ivveshermosilla/Holmes-HWF0910AT-Window-Fan-Smart-Mod/docs/architecture.md

# Architecture

The design separates low-voltage control from the fan's mains power path. An
isolated HLK-10M05 supplies the ESP32-S3 domain. H11AA1 optocouplers report the
AC zero crossing and four original slider contacts. A MOC3023 transfers the
controller's firing command back across the isolation boundary to a BTA08 TRIAC.

```mermaid
flowchart LR
  AC[120 VAC input] --> F[Fuse and protection]
  F --> HLK[HLK-10M05 isolated 5 V]
  HLK --> ESP[ESP32-S3]
  F --> ZC[H11AA1 zero-cross]
  ZC --> ESP
  F --> S[Original sliders]
  S --> H[4 x H11AA1 sensing]
  H --> ESP
  ESP --> MOC[MOC3023 optotriac]
  MOC --> TRIAC[BTA08-600C TRIAC]
  TRIAC --> MOTORS[Twin AC motors]
  ESP --> BUF[SN74AHCT125 level shifter]
  BUF --> LEDS[7 x addressable LEDs]
  ESP --> TEMP[DS18B20]
  ESP --> BTN[New push button on perfboard]
  ESP <--> PWA[Local PWA / OTA]
```

## Control Layers

1. Interrupt handlers timestamp H11 edges and wake a dedicated TRIAC-fire task
   at each zero crossing.
2. The main loop derives mains presence, slider position, temperature, and time.
3. A state machine resolves button, web, thermostat, timer, and schedule requests.
4. The high-priority fire task runs on the other ESP32-S3 core and issues the
   calibrated MOC pulse independently of HTTP/PWA and OneWire processing, so
   loading or logging into the app cannot pause motor firing.
5. LED rendering derives its normal state from the resolved fan mode.
6. HTTP APIs expose state and accept explicit commands; page load is read-only.

The MOC pulse counter is command telemetry. It proves that firmware requested a
gate pulse while the safety conditions were satisfied; it cannot prove current
through the TRIAC or motor. That distinction is important in diagnostics.
