ivveshermosilla/Holmes-HWF0910AT-Window-Fan-Smart-Mod/docs/firmware.md

# Firmware

The Arduino sketch is in
[`firmware/Holmes_HWF0910AT_Smart_Mod/`](../firmware/Holmes_HWF0910AT_Smart_Mod/).
The `data/` directory is the LittleFS image served by the ESP32-S3.

## Safety State Machine

At boot the MOC output is forced low and the mode is `OFF_LOOP`. When zero-cross
activity first establishes that VAC is present, the controller again forces OFF;
the schedule may resume only after VAC is confirmed, the two-second safety
interval has elapsed, and the clock is synchronized.

Short button presses follow:

```text
OFF -> HIGH -> LOW -> HIGH 60 -> HIGH 65 -> HIGH 70 -> HIGH 75 -> HIGH 80
    -> LOW 60 -> LOW 65 -> LOW 70 -> LOW 75 -> LOW 80 -> OFF -> ...
```

A long press of approximately 2.5 seconds from an active original mode enters a
volatile `OFF_MEMORY`; the next short press restores that mode. Removing power
clears the memory. A short press from a custom web speed first returns to OFF.

Every stopped-to-running transition applies 100% for two seconds, then moves to
the requested phase delay. Adjusting an already-running fan does not repeat the
boost.

Zero-cross events wake a dedicated high-priority FreeRTOS task that owns the
short GPIO47/MOC pulse. HTTP serving remains in the application loop, but cannot
delay the phase-fire task. Status telemetry exposes `fireTaskReady`, pulse count,
last pulse gap, and maximum pulse gap so this separation can be regression-tested
while another device loads or logs into the PWA.

## Thermostat And Schedule

Thermostat modes stop at or below the target and resume above it with configured
hysteresis. Weekly entries share one interval among selected start days. Daily
entries retain a separate interval per selected day. An end earlier than start
belongs to the following day; equal times disable that interval.

Schedules and their speed/dimmer values persist in ESP32 Preferences NVM.
The clock is obtained independently from SNTP after Wi-Fi joins the LAN. The
firmware uses the `America/Denver` daylight-saving rule for weekday and minute
boundaries. A browser can also provide the time when SNTP is unavailable;
opening the app never sends a motor command. With no RTC battery, a total power
loss followed by no LAN/Internet and no browser leaves the clock unknown, so the
schedule waits for valid time while manual control remains available.

Clock synchronization is explicitly requested at boot, on each LAN IP recovery,
on VAC recovery, when a client joins the recovery AP, and when the PWA opens or
recovers access. A separate request is made when the Denver local clock crosses
12:00 AM each day, including daylight-saving days. Manual synchronization does
not reset that daily boundary or clear pending automatic requests. Requests are
coalesced and retried at a minimum 15-second interval while the LAN is connected;
without Internet they remain pending while an already valid clock keeps running.
The PWA requests NTP on reconnection and supplies browser time only if the clock
is unknown or the LAN is unavailable. Automatic reconnection does not replace a
valid online clock with the connecting phone's time. Manual Sync still applies
browser time directly. None of these handlers sends a motor command.

`/api/status.time` exposes `lastNtpEpoch`, `lastManualEpoch`, `syncRequests`,
`syncAttempts`, `syncCompletions`, `midnightSyncRequests`, and the reason bitmasks
`syncPending`/`syncLastReasons`: boot=1, LAN=2, AC=4, AP client=8, PWA=16,
midnight=32. A pending request is cleared only by a received NTP response.

An active schedule window owns its end boundary, even when a web command or
button press changes the running mode. If manual control has already started
the motor before a window begins, the window does not restart it or change its
speed; it still turns it off at the scheduled end. Outside the selected window,
manual controls work normally. A manual OFF during a window remains OFF until
the next selected window. After a boot or VAC reconnection inside a window, the
motor resumes only after the AC safety interval.

Temperature history stores one hourly sample for seven days in NVM.
Hourly samples are captured in RAM while motor output is active and committed
after output stops, avoiding flash-backed NVM stalls during TRIAC firing.

Scheduled intermediate speeds use `SPEED_CUSTOM` under schedule ownership. This
authority is independent of the manual custom-slider checkbox: the checkbox
continues to govern direct web control, while an active schedule can apply its
own saved 85-100% value without changing that preference.

## Persistent Power Tracking

Firmware keeps a bounded ring of up to 64 events and exposes it on demand at
`/api/power-log`. Once local time is synchronized, entries older than 24 hours
are removed. Events include ESP reset reason, AC detection/loss,
motor ON/OFF and its requesting subsystem, app session checks, MOC output
blocking/restoration, and TRIAC firing gaps above 12,500 microseconds.

Event capture is immediate in RAM. NVM persistence is deferred whenever the
motor request or TRIAC fire task is active, preventing a diagnostic write from
adding flash latency to phase firing. The next OFF transition commits the full
pending log. This records software decisions and pulse timing; without a
tachometer or isolated current sensor it cannot prove physical blade rotation.

## Zero-Cross And AC Sessions

The zero-cross ISR records each rising-edge interval. Pulse age is calculated
from a timestamp taken after the ISR snapshot, preventing an interrupt between
the two reads from producing an unsigned underflow and a false stale signal.

A gap shorter than 250 ms can temporarily inhibit firing through the normal
freshness gate without changing fan mode or schedule ownership. A gap of at
least 250 ms is treated as an actual AC interruption; the following stable
return executes the required AC-connected safety OFF. This decision is based on
the measured pulse interval, not on how long HTTP work delayed the main loop.
Status exposes both `ageUs` and `sampleElapsedMs` for diagnosis.

## Build

Reference Arduino-ESP32 target options:

```text
esp32:esp32:esp32s3
FlashSize=4M, PartitionScheme=default, FlashMode=dio, CPUFreq=240
PSRAM=disabled
```

Compile with Arduino IDE/CLI using the ESP32 core and the Adafruit NeoPixel
library. Build LittleFS separately from `data/`; for the current 4 MB default
partition layout its image size is `0x160000`. Confirm the partition table from
the compiled build rather than assuming an offset on different boards.

## OTA

System settings accept two distinct Arduino binary artifacts:

- Firmware: the compiled sketch `.bin` sent to the firmware endpoint.
- UI: the generated LittleFS `.bin` sent to the LittleFS endpoint.

The browser displays upload progress; the ESP validates the write and reboots
automatically after success. Keep power stable. Never upload a filesystem image
whose size or partition scheme differs from the installed firmware.

## Wi-Fi Recovery

The ESP runs in AP+STA mode. Its recovery AP remains available while STA joins
the configured 2.4 GHz LAN. STA association uses the ESP auto-reconnect facility
and an independent non-blocking retry loop. Failed joins retry indefinitely with
5, 10, 20, and then 30-second intervals, covering the common case where the ESP
boots faster than the household router after a power outage.

`/api/status` reports the STA status code, recovery state, attempt count,
consecutive failures, next retry delay, and connection age. The authenticated
`POST /api/wifi/reconnect` endpoint restarts only STA; it does not change the
saved schedule or motor command and does not stop the recovery AP.

## First Commissioning

The public source defaults to AP `IvvesFan-Config` and example subnet
`192.168.1.x`; no household SSID or password is embedded. Generic app and OTA
credentials are intentionally visible in source for first commissioning. Change
all credentials from a trusted connection before permanent installation.
