ivveshermosilla/Holmes-HWF0910AT-Window-Fan-Smart-Mod/docs/webapp.md

# Web Application

The ESP32-S3 serves a framework-free, bilingual PWA from LittleFS. It works as a
single-page application with Home/System views and glass-styled detail overlays.

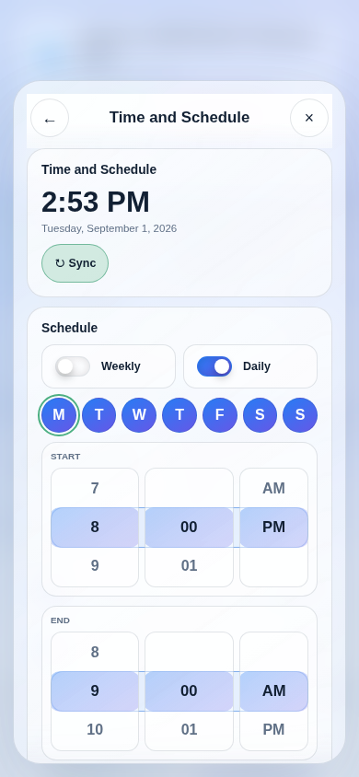
[picture p4: assets/screenshots/mobile-schedule.png]
Mobile schedule


## Home

- Live LAN/AP-recovery, clock sync, zero-cross, and firmware indicators.
- Temperature summary and seven-day hourly detail history.
- Explicit POWER ON (HI) and Power off commands.
- Fan state, shared 85-100% control, HIGH/LOW/temperature presets, and sliders.
- Global LED color/dimmer plus seven physical-function indicators.
- Timer and mutually exclusive Weekly/Daily scheduling with 12-hour time wheels.

## System

- Physical-button enable switch.
- Device-health command telemetry and zero-cross/H11 module activity.
- Persistent Power tracking for the last 24 hours, including reset, AC,
  motor-command, schedule, timer, web, and TRIAC timing causes.
- Wi-Fi scanning, password entry, DHCP connection, last-octet static-IP setup,
  recovery telemetry, and a manual STA-only reconnect command.
- Separate OTA upload controls for firmware and LittleFS with progress/reboot.

## Session Behavior

Unknown devices see an empty login form. A successful login can be remembered in
that browser. Initial page synchronization reads the current state and requests
clock synchronization; opening a second phone does not replay stale controls.
Motor gate timing runs in a separate
real-time task, so serving the login or application assets cannot interrupt an
already active fan mode.

Each app connection or recovery requests NTP through `/api/time` with reason
`app-reconnect`. When the clock is unknown or the LAN is unavailable, the phone
also supplies its current time, even if the fan is already running. A valid
online clock is preserved until NTP responds. Manual Sync directly applies the
browser time. Automatic midnight and reconnection requests remain independent
of manual Sync. Clock corrections allow the saved schedule to evaluate its
actual current start/end boundaries.

Power tracking comes from the ESP32 rather than browser-local activity. Its
  summary and detail overlay show newest events first. A PWA session check is
recorded for correlation, but log writes are deferred while motor firing is
active and committed when the output is stopped. The controller never treats a
page load or login as a fan command.

Periodic synchronization requests only `/api/status` every three seconds. The
larger power log is loaded from `/api/power-log` when System is opened and then
at 30-second intervals while that view remains visible. Seven-day temperature
history is similarly loaded from `/api/temp-history` only when its detail view
opens. This keeps ordinary control telemetry responsive on a weak local Wi-Fi
link without removing either diagnostic record.

The default generic app login is `thankyou` / `youarewelcome`. It is not a cloud
identity system and should be changed during commissioning.

The detail presentation is technically a **modal overlay** (also called a modal
dialog). Cards kept on Home do not open one unless additional detail is useful.
