ivveshermosilla/Holmes-HWF0910AT-Window-Fan-Smart-Mod/docs/engineering-decisions.md

# Engineering Decisions And Challenges

| Challenge | Evidence | Decision and resolution | Validation |
| --- | --- | --- | --- |
| Original supply was not safely isolated | Board tracing contradicted the early assumption | Replace the control board and power the ESP32 from an HLK-10M05 | Isolated controller domain documented and installed |
| H11 inventory/roles changed during tracing | Five optocoupler functions were found | Assign one ZC plus four explicit slider inputs | Live H11 counters and position labels exposed in System |
| LED wiring produced a short | Physical LED test failed before mains testing | Correct wiring before continuing firmware tests | Seven-pixel color and function tests restored |
| GPIO21 and GPIO47 were reversed in an early build | LED and motor behavior contradicted board wiring | Fix LED DATA=21, MOC=47 and reject stale LED-pin NVS | Correct pin map compiled, flashed, and retained |
| DS18B20 accumulated read errors | Presence/read counters showed repeated failures | Correct one-wire timing and GPIO handling | Stable live readings with zero accumulating errors |
| Low speed needs reliable startup torque | Direct low-power starts were mechanically weak | Apply two seconds at full power only from stopped state | HIGH-to-lower transition observed without app-visible bounce |
| Mobile individual color picker closed early | Re-render replaced the active input | Separate immediate preview from state refresh | Picker remains usable and changes render immediately |
| A second browser caused a brief motor interruption | Login sent no motor command, but synchronous HTTP file serving delayed loop-driven MOC pulses | Keep startup read-only and move MOC timing to a dedicated high-priority task | Pulse-gap telemetry verifies continuity while another client loads the PWA |
| Overnight schedules cross weekday boundaries | End time can be numerically earlier than start | Bind weekday to start; carry end into next day | Monday 10 PM to Tuesday 7 AM resolves as one interval |
| Scheduled intermediate speed did not run when the manual slider checkbox was off | Schedule mode selected `CUSTOM`, but motor logic still required the unrelated manual enable flag | Give active schedule control independent authority over its persisted 85-100% value | Live 93% schedule reported motor requested, fire allowed and stable firing |
| Intermittent stops needed evidence without creating new timing stalls | Browser activity was volatile and immediate NVM writes can stall flash-backed execution | Keep a 24-hour bounded controller log in RAM while firing and flush it after output stops | Reset, command and pulse events survive reboot; 12-session load produced no new gap event |
| Live 120 Hz ZC was intermittently classified stale | `micros()` was captured before the ISR snapshot, allowing an intervening edge to underflow unsigned pulse age; slow status responses could then exceed the 1.5 s AC threshold | Timestamp after snapshot, detect real AC sessions from ISR-measured gaps >=250 ms, preserve mode through shorter gaps, and split large histories from periodic status | Installed schedule remained driving under concurrent client load with stable ZC and no additional AC transition |
| 5 GHz network could not be joined | ESP32-S3 scan/join behavior | Provision a 2.4 GHz SSID through AP mode | LAN operation and OTA established |
| OTA must update code and UI independently | App and LittleFS use separate partitions | Provide two upload endpoints and progress/reboot flow | Both image types accepted and served after reboot |

The record deliberately includes failures because the corrective loop is part of
the engineering outcome: observe, isolate the cause, reduce risk, change one
thing, and verify the real device.
