ivveshermosilla/Holmes-HWF0910AT-Window-Fan-Smart-Mod/docs/gallery.md

# Project Gallery

Only representative images are included. The source set remains private because
raw phone images contained location metadata and Live Photo companions. Public
derivatives were auto-oriented, resized, and stripped of metadata.

## Condition And Investigation

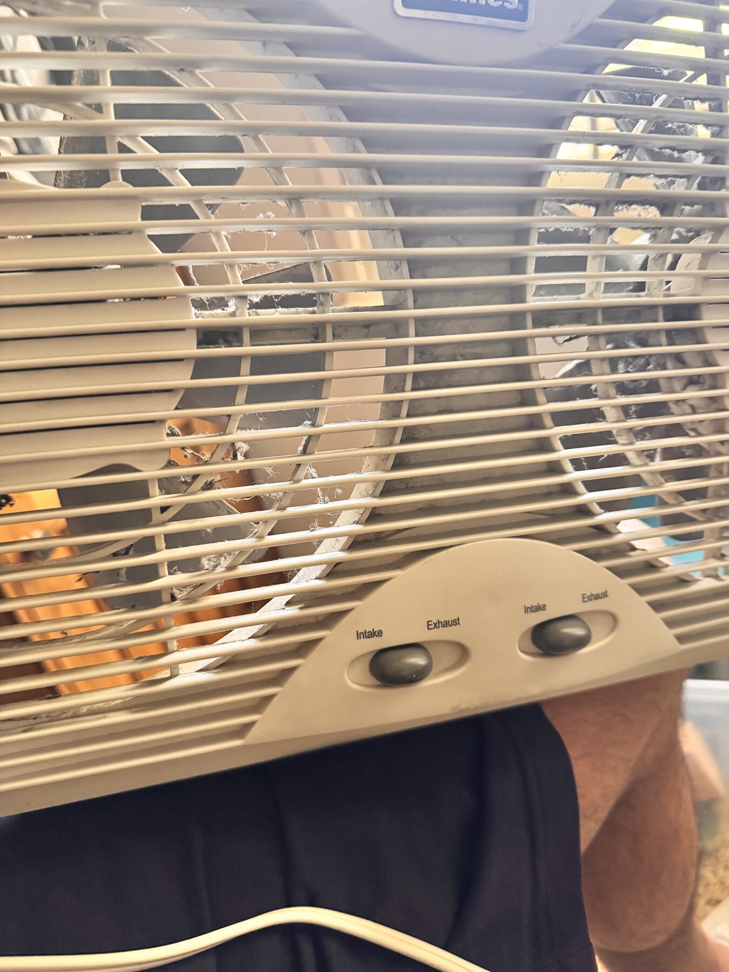
[picture p5: assets/photos/01-condition-as-received.jpg]
Condition as received


**Condition as received, before service.** The fan was operational but had
accumulated dust and lint during extended airflow duty, as window fans normally
do. The condition was documented before disassembly rather than concealed.

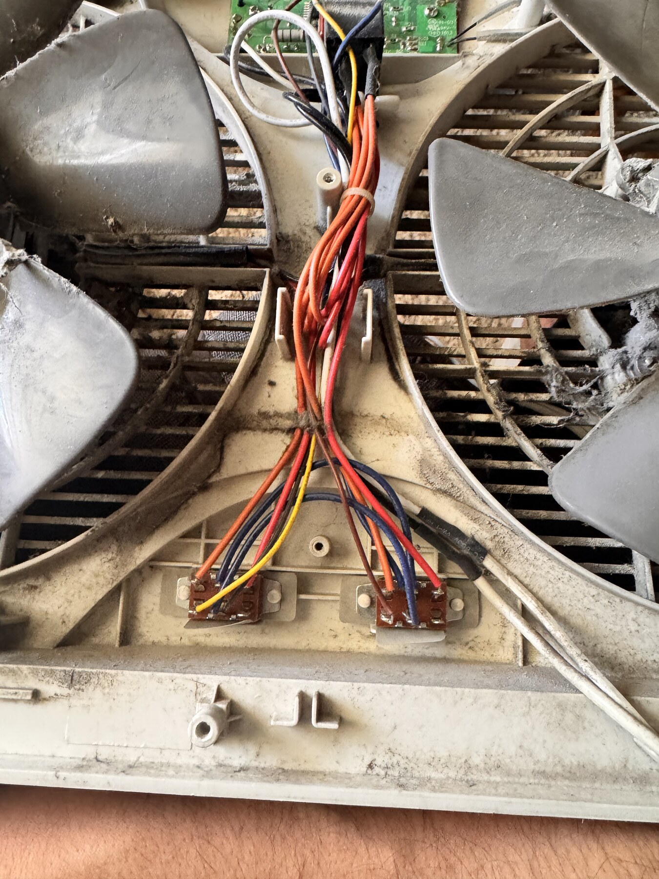
[picture p6: assets/photos/02-original-internals.jpg]
Original internals


Original internal layout before replacement of the non-isolated controller.

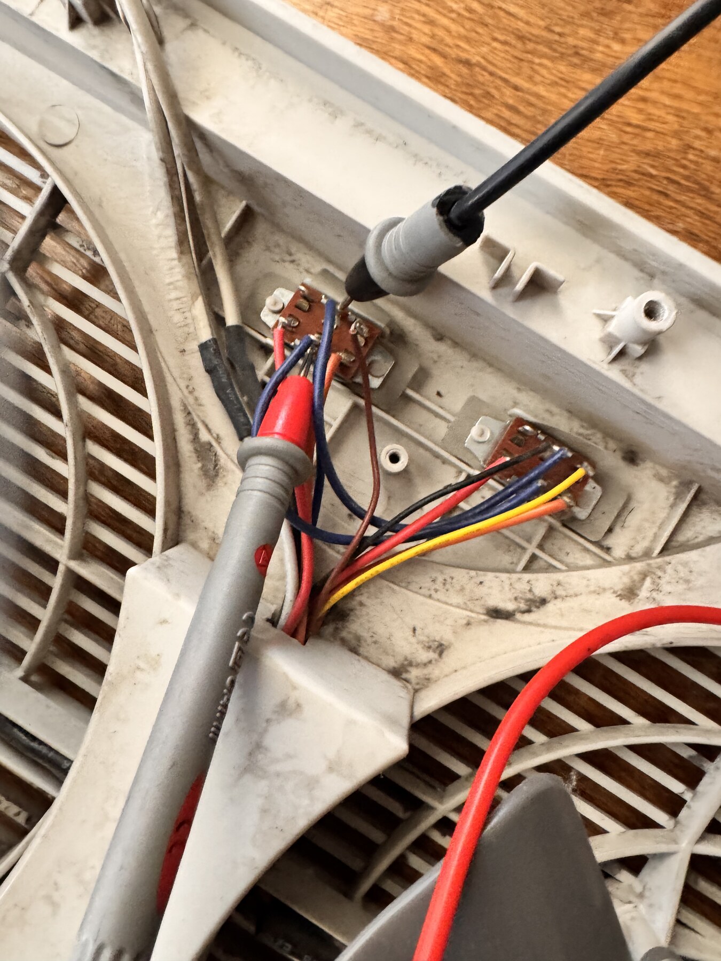
[picture p7: assets/photos/04-reverse-engineering-measurement.jpg]
Reverse-engineering measurement


Tracing and measuring the existing control paths before assigning GPIO roles.

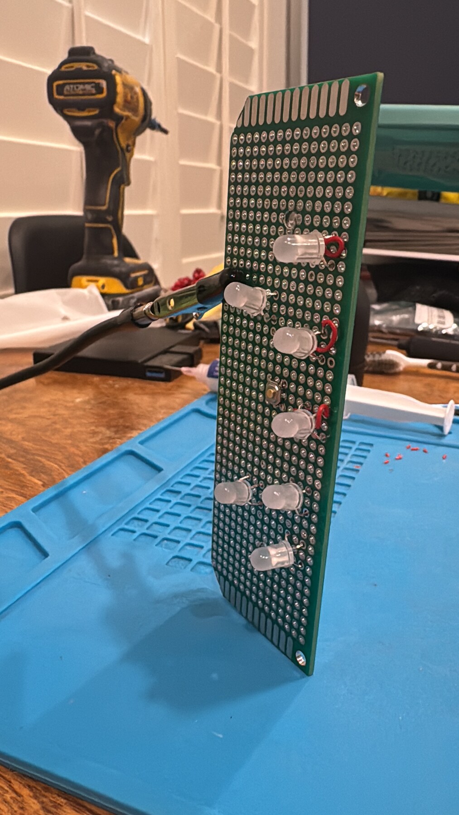
[picture p8: assets/photos/05-indicator-board-layout.jpg]
Indicator board


The original seven-position indicator layout informed the final LOW/temperature/
HIGH order and the digital representation in the PWA.

## Smart Mod Integration

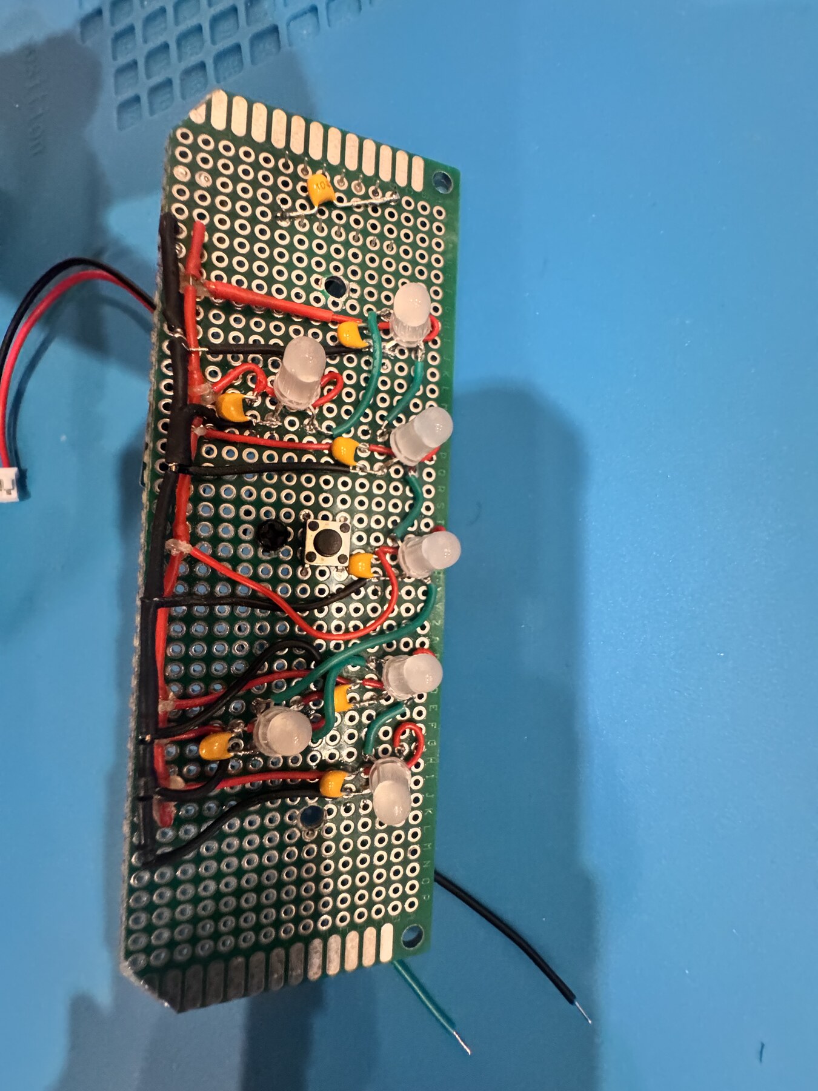
[picture p9: assets/photos/06-controller-board-assembly.jpg]
Controller assembly


Low-voltage controller assembly during integration.

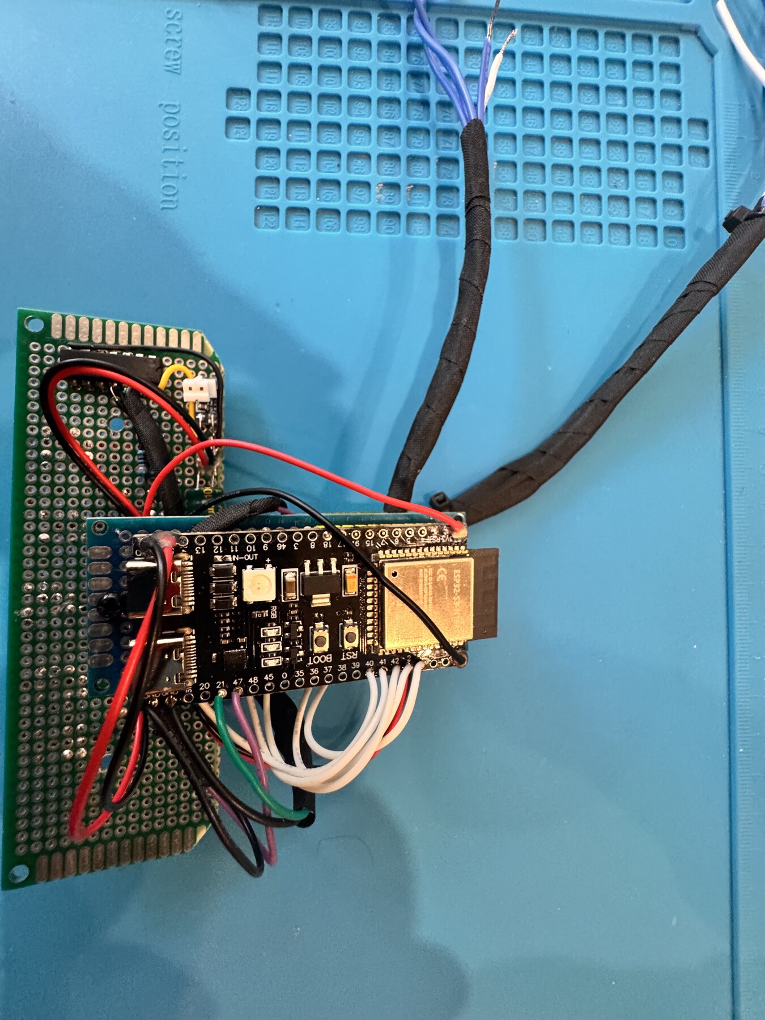
[picture p10: assets/photos/07-esp32s3-controller-complete.jpg]
Completed ESP32-S3 controller


Completed ESP32-S3 controller before final installation.

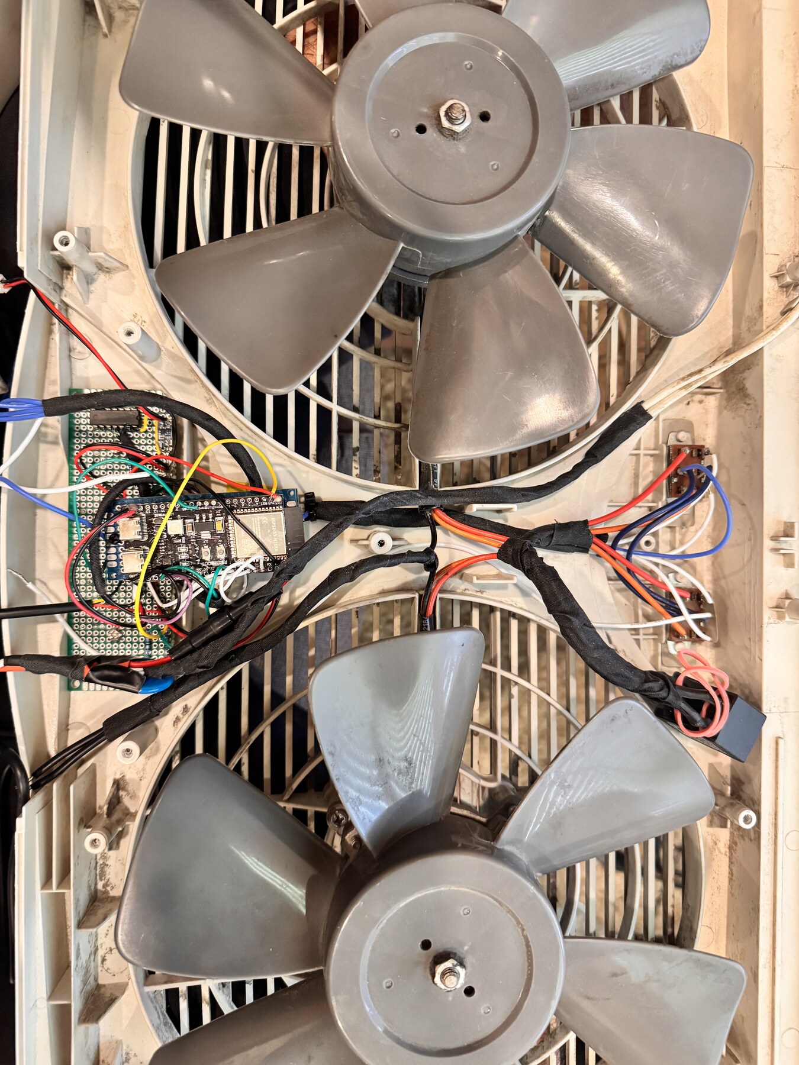
[picture p11: assets/photos/08-controller-installed.jpg]
Controller installed


Controller installed in the fan enclosure.

## Final Condition After Service

Front after service

Front view after service and integration.

Rear after service

Rear view after service. The before/after comparison records the improvement
without presenting normal accumulated dust as the owner's living conditions.

## Application

Desktop Home

Desktop Home view served by the installed firmware.

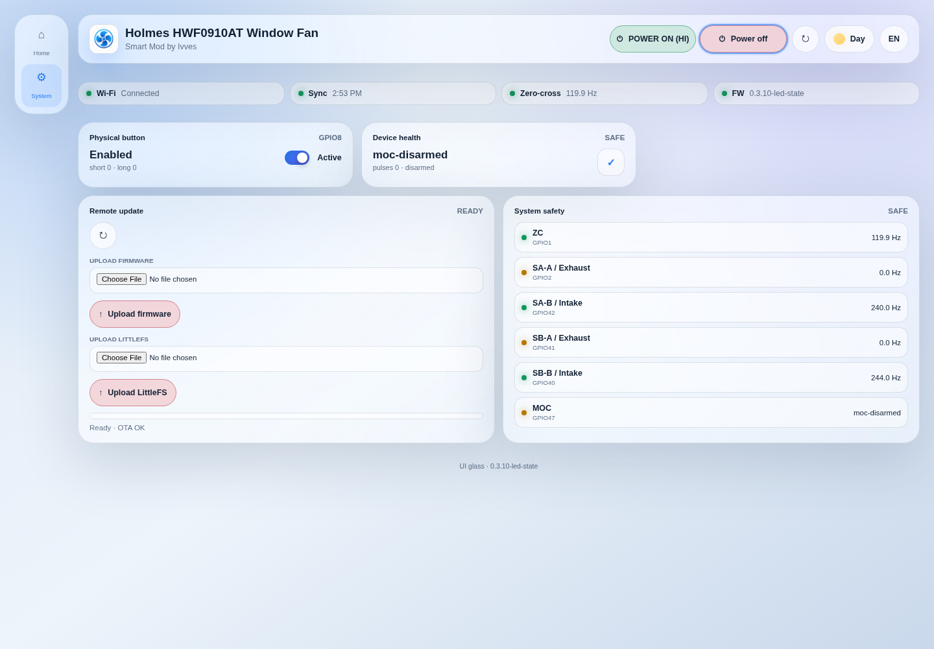
[picture p12: assets/screenshots/desktop-system.png]
Desktop System


System diagnostics and separate firmware/LittleFS OTA controls. Household Wi-Fi
and activity details were intentionally excluded from the portfolio capture.

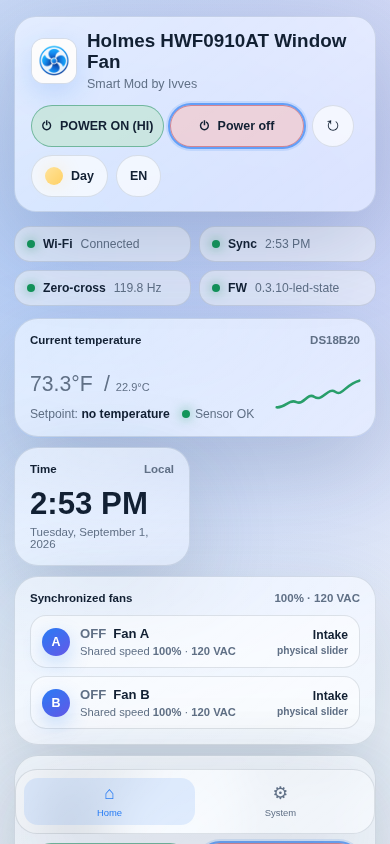
[picture p13: assets/screenshots/mobile-home.png]
Mobile Home


Installable mobile PWA layout.

Mobile schedule

Daily schedule and native-style 12-hour time wheels.
