ivveshermosilla/Holmes-HWF0910AT-Window-Fan-Smart-Mod/assets/diagrams/README.md

# Diagrams

Architecture and connection diagrams are maintained as Mermaid source inside the
Markdown documentation so GitHub can render them and future electrical changes
remain reviewable as text.

- [`docs/architecture.md`](../../docs/architecture.md): system and isolation blocks
- [`docs/hardware.md`](../../docs/hardware.md): MOC/TRIAC connection network
- [`docs/pinout.md`](../../docs/pinout.md): GPIO and indicator maps
- [`docs/firmware.md`](../../docs/firmware.md): physical-button state sequence
