ivveshermosilla/Holmes-HWF0910AT-Window-Fan-Smart-Mod/docs/testing.md

# Testing And Validation

## Bench Stages

1. Power-off continuity and component identification.
2. Isolated 5 V bring-up with mains motor output disabled.
3. LED and DS18B20 tests after correcting physical wiring.
4. Zero-cross frequency and four H11 activity checks at 120 VAC.
5. MOC/TRIAC firing with both original sliders in known positions.
6. HIGH/LOW/custom speed, two-second boost, OFF, thermostat, and button loop.
7. Timer and weekly/daily same-day and overnight schedule behavior.
8. PWA login, mobile layout, second-device read-only synchronization, and PWA assets.
9. Firmware and LittleFS OTA upload followed by automatic reboot and status check.

## Current Evidence

- Reference version: `0.3.19-clock-reconnect`.
- Zero-cross telemetry near 120 edge events per second on 60 Hz mains.
- DS18B20 live values with no current read-error accumulation.
- MOC remains disarmed while OFF; commanded pulse count increments only when armed.
- Four slider optocoupler channels expose live activity and Intake/Exhaust labels.
- Desktop and mobile screenshots were captured directly from the installed PWA.
- The operating sketch compiled at 1,077,365 bytes (82% of the app partition)
  with 50,380 bytes (15%) of global RAM. The sanitized public sketch compiled at
  1,077,233 bytes with the same global RAM use.
- Twelve complete PWA downloads plus twelve new-device logins completed with no
  HTTP failures while HIGH remained active.
- During that test `firePulseCount` reached 7,714, zero-cross stayed at 120.0 Hz,
  and the maximum fire gap was 8,437 us, below a missed 60 Hz half-cycle.
- DS18B20 recorded zero read, reset, and CRC errors through 67 successful resets
  during the same motor/network load test.
- A live schedule test selected `CUSTOM` at 93% with the manual custom checkbox
  false. Status reported mode 13, `motorRequested=true`, `fireAllowed=true`,
  schedule driving, 93%, and the scheduled 37% LED dimmer after the two-second
  start boost.
- Twelve simulated new-device flows each requested session, login, application,
  config, and status while that 93% schedule was active. TRIAC pulses increased
  from 868 to 2447, the maximum gap remained 9487 us, and no output-gap or
  output-blocked event appeared.
- Restoring the saved Daily schedule produced matching persistent ON/OFF events
  at 93%, returned the controller to OFF, and preserved the original seven-day
  schedule values.
- The 0.3.15 LittleFS image used PWA cache `hwf0910at-pwa-v5`.
- The 0.3.16 operational sketch compiled at 1,081,817 bytes (82%) with
  51,684 bytes of global RAM; the public sketch compiled at 1,081,673 bytes.
- Firmware and LittleFS OTA completed with the saved Daily schedule intact.
  After local-time synchronization it resumed `CUSTOM` 100%, schedule driving,
  motor requested, MOC armed, and firing allowed at approximately 120 Hz.
- Periodic status is 4,568 bytes; the 6,578-byte power log and 1,188-byte
  temperature history are fetched separately. Installed source and served PWA
  hashes matched, and the cache is `hwf0910at-pwa-v6`.
- Twelve complete app-entry flows preserved scheduled output. A subsequent
  ten-minute test used three clients polling status every three seconds plus a
  fourth client loading the power log every 30 seconds: 579 status samples, 20
  log requests, zero HTTP errors, zero invalid fan states, zero unstable ZC
  samples, and 71,982 additional TRIAC pulses. Maximum request latency reached
  3.056 seconds without changing AC state; maximum fire gap remained 8,488 us.
- Final installed state was left running from the saved Daily schedule at
  `CUSTOM` 100%, with schedule active/driving, MOC armed, firing allowed,
  120.0 Hz ZC, AC connection count 1, and zero temperature/CRC errors.
- The 0.3.17 operational sketch compiled at 1,083,953 bytes (82%) with
  51,716 bytes of global RAM; the public sketch compiled at 1,083,821 bytes.
- Firmware and LittleFS OTA succeeded through the recovery AP. After reboot the
  ESP associated with the saved SSID, restored its configured static LAN IP, and
  served authenticated status through both AP and LAN.
- A manual STA-only disconnect/reconnect increased the attempt counter from one
  to two. During the test TRIAC pulses advanced from 1,386 to 1,641 while
  `motorRequested`, `mocArmed`, and `fireAllowed` all remained true.
- The final PWA cache is `hwf0910at-pwa-v7`; its top indicator distinguishes
  `LAN connected` from `Recovery AP`.
- On 0.3.17 after a power-on reset, the saved schedule was still present but
  `time.synced=false` after more than 15 hours. A manually running fan prevented
  the previous browser fallback from setting the clock.
- On 0.3.18, a boot reached `time.synced=true`, source `ntp`, UTC-6 without
  opening the PWA. The operational/public sketches compiled at 1,101,757 /
  1,101,629 bytes (84%); global RAM was 51,900 bytes (15%).
- Manual HIGH before 10:48 stayed on through the window and ended by
  `schedule-end` exactly at 10:49:00. A separate 10:51-10:52 window started
  automatically at CUSTOM 93%; changing to manual LOW left the window active
  and produced `schedule-end` at 10:52:00.
- Reboot into an active window initially exposed an early start before AC was
  confirmed. The final build gates schedule starts on confirmed AC: boot and
  `ac-present` logged OFF, followed by `schedule-start` about two seconds later.
- A forced STA reconnect preserved the clock and schedule. The original Daily
  schedule was restored and verified on all seven days after testing.

## Clock Reconnection Verification - 2026-10-08

- Operational/public 0.3.19 sketches compiled at 1,104,293 / 1,104,145 bytes
  (84%), with 51,964 bytes of global RAM (15%). Both LittleFS images built.
- Firmware and LittleFS OTA succeeded. Served HTML and service-worker SHA256
  matched the operational sources; the PWA cache is `hwf0910at-pwa-v9`.
- Boot obtained NTP autonomously; an AP-client association also generated a
  request. Reconnecting the app triggered a new completed NTP response.
- An app reconnection carrying a deliberately one-hour-ahead browser timestamp
  preserved the valid online ESP clock. Manual time sync still worked.
- A forced LAN reconnect during manual HIGH produced a fresh completed NTP
  response. All 32 live samples retained motor request, MOC arming, allowed
  firing and the same AC-session count. Pulses advanced by 4,773; maximum pulse
  gap was 8,402 us and temperature errors remained zero.
- Restored the initial OFF state outside schedule hours. Compared the complete
  saved seven-day Daily schedule before/after: no changes.
- Portable tests cover all request reasons, offline retry, manual independence,
  midnight on successive Denver dates, year rollover, millisecond overflow,
  and the 25-hour fall daylight-saving day. Midnight was simulated in tests;
  this daytime verification did not wait for or alter the real ESP clock to
  reach midnight.
- PWA tests cover first connection, recovered access, reboot detection, manual
  sync, and ensure these flows only post to the time endpoint.

Run the portable regression tests from the repository root:

```bash
g++ -std=c++11 -Wall -Wextra -pedantic tests/clock_policy_test.cpp -o /tmp/fan-clock-test
/tmp/fan-clock-test
node tests/clock_webapp_test.cjs
```

## Measurement Limits

No current transformer, tachometer, or TRIAC-output voltage feedback is installed.
Therefore software cannot independently prove blade rotation, delivered RMS
voltage, or TRIAC conduction. Device Health reports prerequisites and command
activity, not a closed-loop motor measurement.

Still pending: extended thermal soak, quantified airflow/noise, calibrated LED
color transfer, electrical waveform captures, and a final operating video.
