ivveshermosilla/Holmes-HWF0910AT-Window-Fan-Smart-Mod/(commit log)

2026-09-02 Correct hardware record and isolate TRIAC timing
    [Holmes_HWF0910AT_Smart_Mod.ino]
2026-09-08 Fix scheduled custom speeds and add power tracking
    [Holmes_HWF0910AT_Smart_Mod.ino]
2026-09-11 Fix zero-cross stability under web load
    [Holmes_HWF0910AT_Smart_Mod.ino]
